l00nix/rpi-cm4-LiM-board/README.md

This repository builds the GitHub pages site: [https://lim.loonix.ca](https://lim.loonix.ca)
