l00nix/rpi-cm4-LiM-board/pages/LiM_Cluster_CB.md

---
title: LiM Cluster Carrier Board
layout: page
carousels:
  - images: 
    - image: /images/LiM_CM4_Cluster_CB/LiM_CM4_Cluster_CB5.png
    - image: /images/LiM_CM4_Cluster_CB/LiM_CM4_Cluster_CB1.jpg
    - image: /images/LiM_CM4_Cluster_CB/LiM_CM4_Cluster_CB2.jpg
    - image: /images/LiM_CM4_Cluster_CB/LiM_CM4_Cluster_CB3.jpg
    - image: /images/LiM_CM4_Cluster_CB/LiM_CM4_Cluster_CB4.jpg
    - image: /images/LiM_CM4_Cluster_CB/LiM_CM4_Cluster_CB6.jpg
---

# RPi CM4 - LiM Cluster Carrier Board

The third version of the minimalistic LiM Raspberry Pi (RPi) Compute Module 4 (CM4) Carrier Board series.  The Less-is-More (LiM) Cluster Board is a minimalistic Power over Ethernet (PoE) carrier board for the Raspberry Pi (RPi) Compute Module 4 (CM4). On a small footprint it features the following:

* RPi Pi Compute Module 4 (CM4) support (both versions with and w/o eMMC - Lite version)
* PoE Gigabit RJ45 port (GbE)
* USB-C (USB 2.0) for CM4 module flashing (power + data)
* toggle switch for boot/flash mode
* microSD card slot
* 2232 and 2241 M.2 M-key socket dedicated for NVMe PCIe SSD drives
* Fan Pins
* SDA, SDC, YCC, GND pins for OLED Displays

{% include carousel.html height="75" unit="%" duration="7" number="1" %}
_**Various LiM CM4 Cluster Carrier Board models**_

See also on [hackaday.io](https://hackaday.io/project/185519-lim-rpi-cm4-cluster-board){:target="_blank"}
