l00nix/rpi-cm4-LiM-board/pages/LiM+_Board.md

---
title: LiM+ Carrier Board
layout: page
---

# RPi CM4 - LiM+ Carrier Board

The second version of the minimalistic LiM Raspberry Pi (RPi) Compute Module 4 (CM4) Carrier Board. Less-is-More (LiM) refers to the minimalistic design in its [original version](../pages/LiM_Board.html) only providing 5V power via USB-C power connector and two status (power/activity) LEDs. The LiM+ Carrier Board is the 'larger' (not by size but by functionality) sibling to the LiM Board by adding flashing capability of the Compute Module 4. Flashing can be done similarly to the [flashing process](https://www.raspberrypi.org/documentation/hardware/computemodule/cm-emmc-flashing.md){:target="_blank"} with the [CM4 IO board](https://www.raspberrypi.org/products/compute-module-4-io-board/){:target="_blank"}. 

This board is also meant for CM4 boards with onboard storage and wifi as this carrier board provides no other functionalty other than power, status LEDs and above mentioned flashing capability.

It took about two months from idea to the prototype. The PCB design files are can be found [here](https://github.com/l00nix/rpi-cm4-LiM-board/tree/main/hardware/rpi-cm4-LiM%2B-board){:target="_blank"}. 

Here are some pictures and 3D renders of the LiM Carrier Board:

LiM+ Carrier Board - top view             |  LiM+ Carrier Board - bottom view
:-------------------------:|:-------------------------:
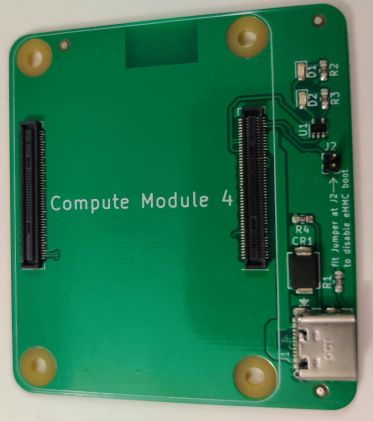
[picture p1: images/LiM+_top.jpg]
LiM+ Carrier Board Top View
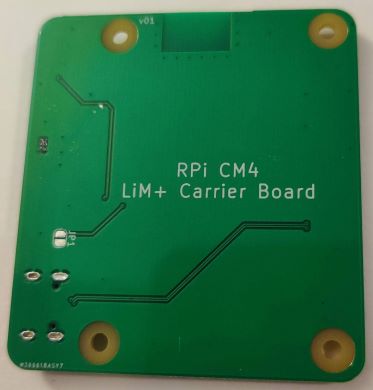
[picture p2: images/LiM+_bottom.jpg]
LiM+ Carrier Board Bottom View
  |  

LiM+ Carrier Board - with CM4             | 
:-------------------------:|:-------------------------:
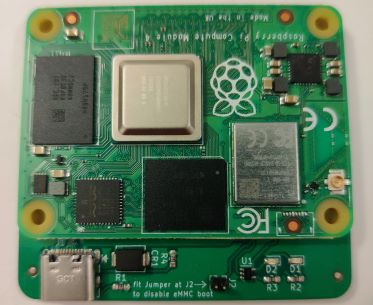
[picture p3: images/LiM+_with_CM4.jpg]
LiM+ Carrier Board with CM4 Module
  |

LiM+ Carrier Board 3D Render - top view             |  LiM+ Carrier Board 3D Render - bottom view
:-------------------------:|:-------------------------:
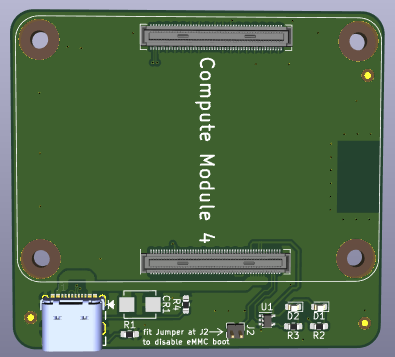
[picture p4: images/rpi-cm4-LiM+-board-3Dtop.PNG]
Rendered RPi CM4 LiM+ Carrier Board PCB Top
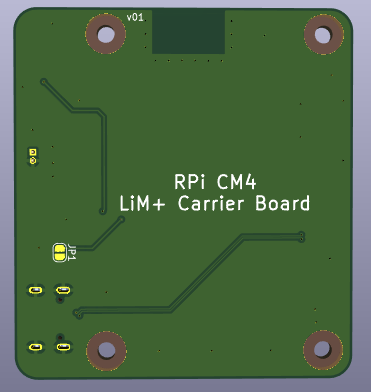
[picture p5: images/rpi-cm4-LiM+-board-3Dbottom.PNG]
Rendered RPi CM4 LiM+ Carrier Board PCB Bottom
  |  

LiM+ Carrier Board - 3D top view             |  LiM+ Carrier Board - 3D side view
:-------------------------:|:-------------------------:
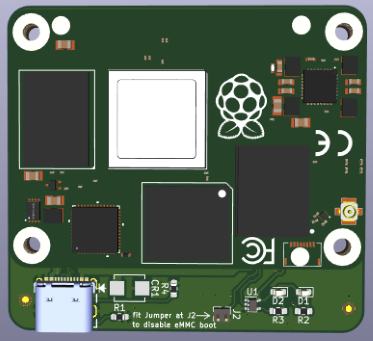
[picture p6: images/rpi-cm4-LiM+-board-3DtopwithCM4.PNG]
3D RPi CM4 LiM+ Carrier Board PCB Top
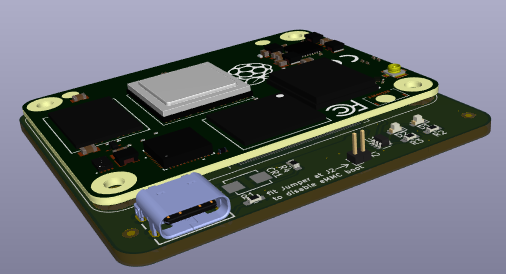
[picture p7: images/rpi-cm4-LiM+-board-3DsidewithCM4.PNG]
3D RPi CM4 LiM Carrier Board PCB Side
  |  

LiM+ Carrier Board - 3D breakout with heatsink             |  LiM+ Carrier Board - 3D with heatsink
:-------------------------:|:-------------------------:
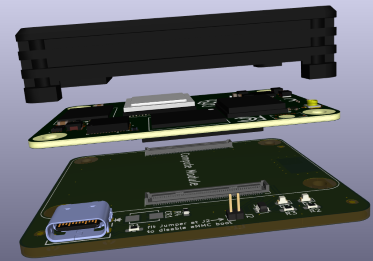
[picture p8: images/rpi-cm4-LiM+-board-3d-heatsink.PNG]
3D RPi CM4 LiM+ Carrier Board PCB breakout with heatsink
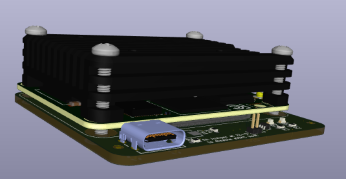
[picture p9: images/rpi-cm4-LiM+-board-3Dwithscrews.PNG]
3D RPi CM4 LiM Carrier Board PCB with heatsink
  |  

You can read more about my RPi musings and projects on my [l00nix's RPi Musings Blog](https://rpi.loonix.ca/){:target="_blank"}.

## About

[//]: # "GitHub Stats (https://github.com/l00nix/rpi-cm4-LiM-board){:target="_blank"}"
GitHub Stats (https://github.com/l00nix/rpi-cm4-LiM-board){:target="_blank"}

This project is maintained by [Alexander Rau](https://rpi.loonix.ca){:target="_blank"}. The Raspberry Pi Compute Module 4 is a product of [Raspberry Pi (Trading) Limited](https://www.raspberrypi.org/about/){:target="_blank"}.
