l00nix/rpi-cm4-LiM-board/pages/LiM_Board.md

---
layout: page
title: LiM Carrier Board
---

# RPi CM4 - LiM Carrier Board

The first version of the minimalistic Raspberry Pi (RPi) Compute Module 4 (CM4) Carrier Board. Less-is-More (LiM) refers to the minimalistic design only providing 5V power via USB-C power connector and two status (power/activity) LEDs.

This is meant for CM4 boards with onboard storage and wifi as this carrier board provides no other functionalty other than power and status LEDs.

It took about two months from idea to the prototype. The PCB design files are can be found [here](https://github.com/l00nix/rpi-cm4-LiM-board/tree/main/hardware/rpi-cm4-LiM-board). 

Here are some pictures and 3D renders of the LiM Carrier Board:

LiM Carrier Board - top view             |  LiM Carrier Board - bottom view
:-------------------------:|:-------------------------:
LiM Carrier Board Top View  |  Rendered RPi CM4 LiM Carrier Board PCB Bottom

LiM Carrier Board - with CM4             |  LiM Carrier Board - running
:-------------------------:|:-------------------------:
LiM Carrier Board Top View  |  Rendered RPi CM4 LiM Carrier Board PCB Bottom

<iframe width="560" height="315" src="https://www.youtube.com/embed/IoSWfgwpsAo" title="YouTube video player" frameborder="0" allow="accelerometer; autoplay; clipboard-write; encrypted-media; gyroscope; picture-in-picture" allowfullscreen></iframe>
_**VID1 - LiM Carrier Board booting up**_

LiM Carrier Board 2D Render - top view             |  LiM Carrier Board 2D Render - bottom view
:-------------------------:|:-------------------------:
Rendered RPi CM4 LiM Carrier Board PCB Top  |  Rendered RPi CM4 LiM Carrier Board PCB Bottom

LiM Carrier Board - 3D top view             |  LiM Carrier Board - 3D side view
:-------------------------:|:-------------------------:
3D RPi CM4 LiM Carrier Board PCB Top  |  3D RPi CM4 LiM Carrier Board PCB Side

You can read more about my RPi musings and projects on my [l00nix's RPi Musings Blog](https://rpi.loonix.ca/).

## About

[//]: # "GitHub Stats (https://github.com/l00nix/rpi-cm4-LiM-board)"
GitHub Stats (https://github.com/l00nix/rpi-cm4-LiM-board)

This project is maintained by [Alexander Rau](https://rpi.loonix.ca). The Raspberry Pi Compute Module 4 is a product of [Raspberry Pi (Trading) Limited](https://www.raspberrypi.org/about/).
