l00nix/rpi-cm4-LiM-board/images/IMG_20211019_1241092.jpg

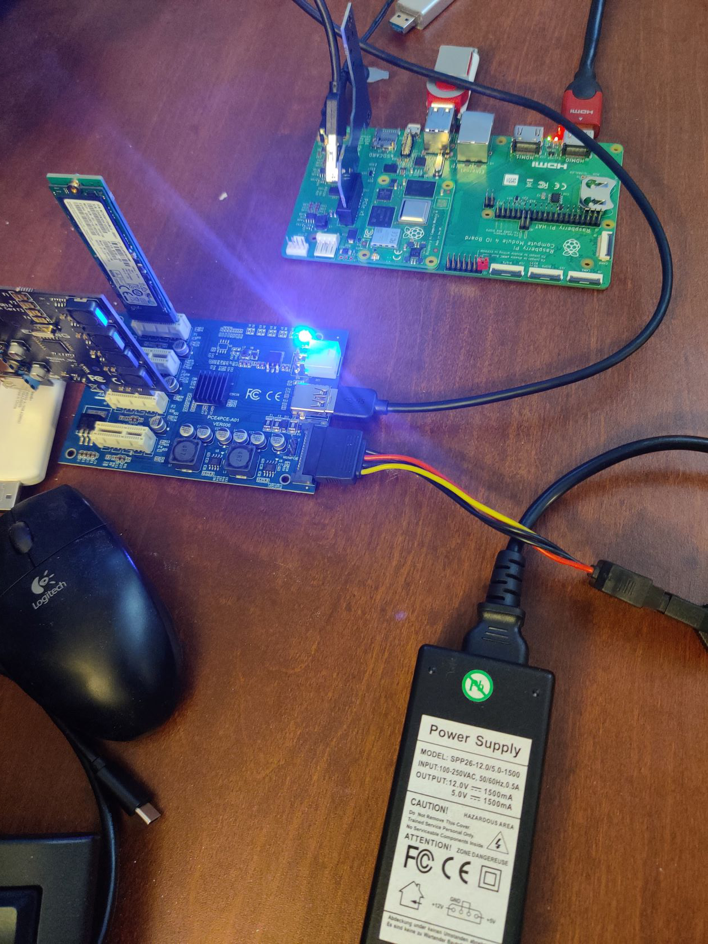
images/IMG_20211019_1241092.jpg
