l00nix/rpi-cm4-LiM-board/images/LiM_CM4_Cluster_CB/LiM_CM4_Cluster_CB2.jpg

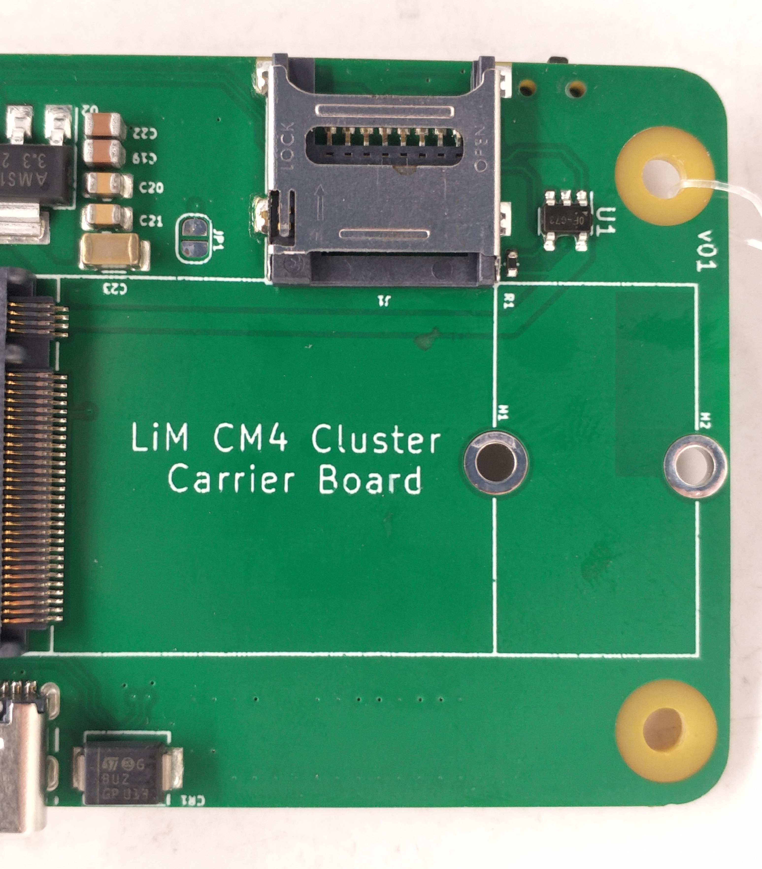
images/LiM_CM4_Cluster_CB/LiM_CM4_Cluster_CB2.jpg
