l00nix/rpi-cm4-LiM-board/hardware/rpi-cm4-LiM+-board/KiCad Files/USB4105-GF-A/USB4105-GF-A--3DModel-STEP-56544.STEP

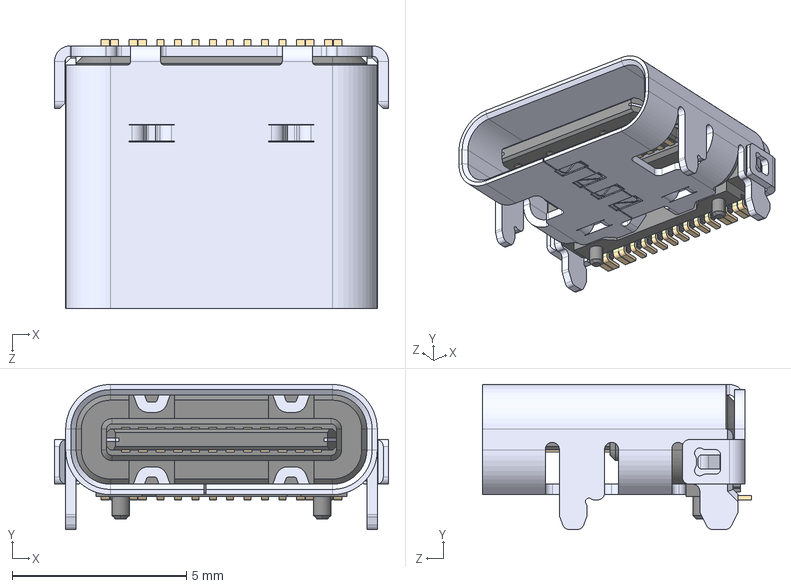
[picture p17: CAD file, 2021-07-24]
hardware/rpi-cm4-LiM+-board/KiCad Files/USB4105-GF-A/USB4105-GF-A--3DModel-STEP-56544.STEP
9.58 x 4.16 x 7.71 mm
