l00nix/rpi-cm4-LiM-board/hardware/rpi-cm4-LiM+-board/KiCad Files/Screw/95836A283_BLACK-OXIDE 18-8 STAINLESS STEEL PAN HEAD PHILLIPS SCREWS.STEP

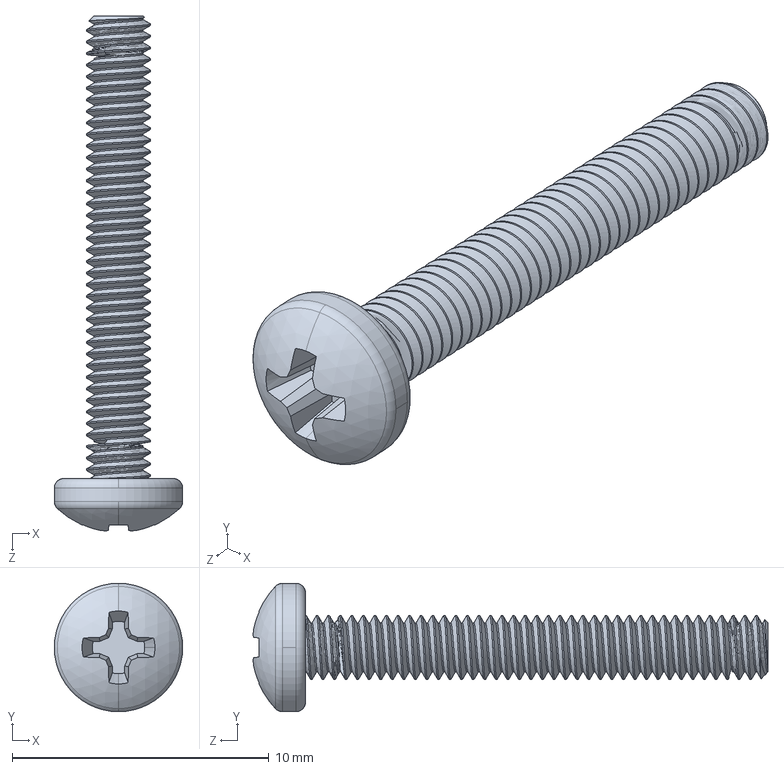
[picture p18: CAD file, 2021-08-02]
hardware/rpi-cm4-LiM+-board/KiCad Files/Screw/95836A283_BLACK-OXIDE 18-8 STAINLESS STEEL PAN HEAD PHILLIPS SCREWS.STEP
5.00 x 5.00 x 20.0 mm
