l00nix/rpi-cm4-LiM-board/hardware/rpi-cm4-LiM+-board/KiCad Files/Screw/96315A112_METRIC 18-8 STAINLESS STEEL THIN HEX NUTS.STEP

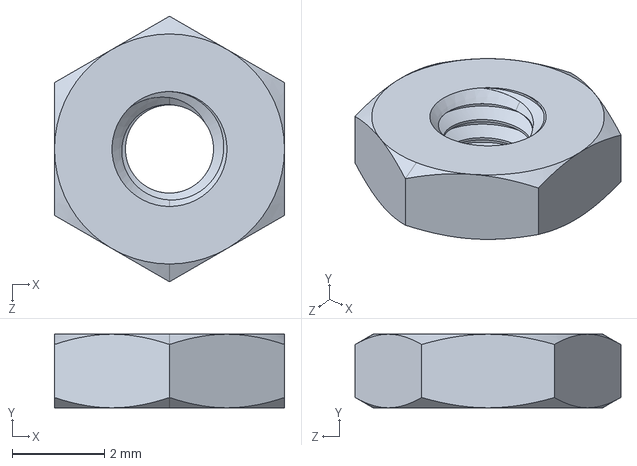
[picture p19: CAD file, 2021-08-02]
hardware/rpi-cm4-LiM+-board/KiCad Files/Screw/96315A112_METRIC 18-8 STAINLESS STEEL THIN HEX NUTS.STEP
5.00 x 1.60 x 5.77 mm
