l00nix/rpi-cm4-LiM-board/hardware/rpi-cm4-LiM-board/KiCad Files/rpi-cm4-LiM-board.pdf

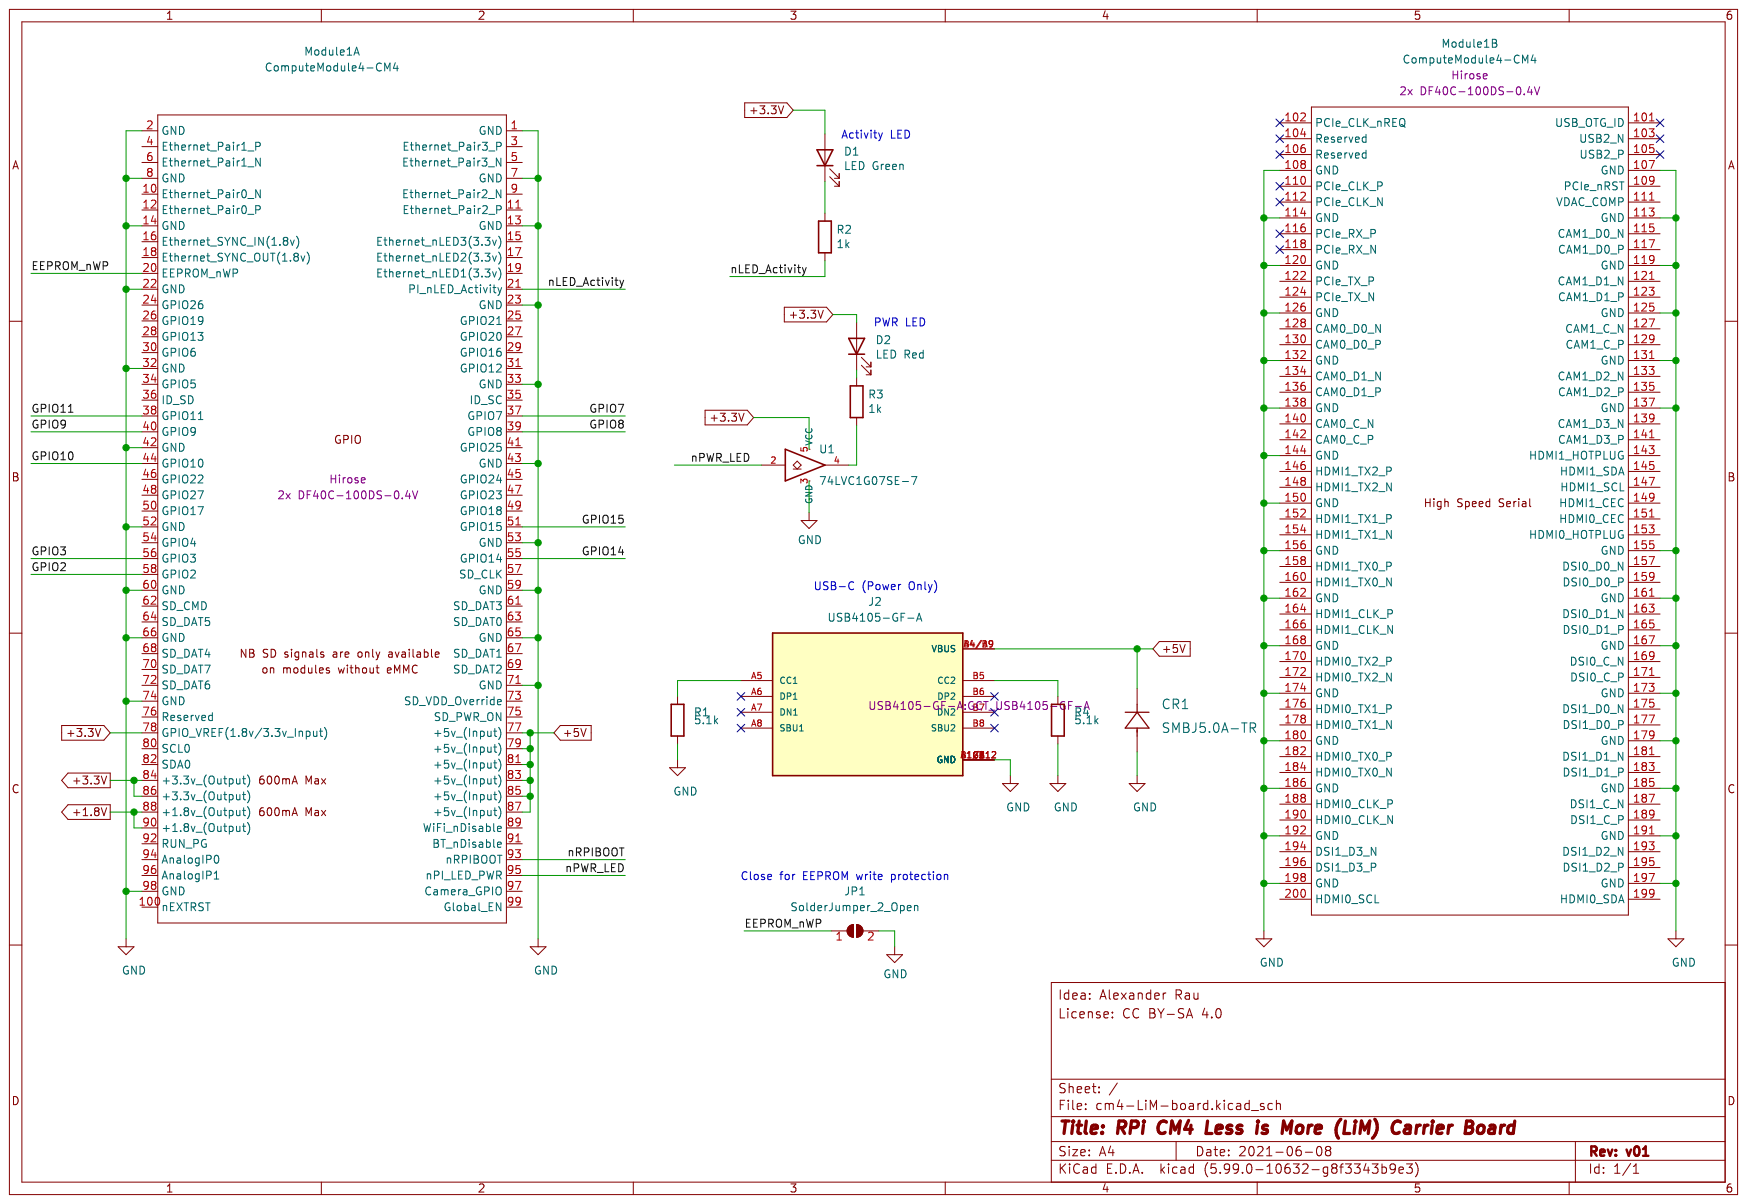
[picture p20: page 1]
