l00nix/rpi-cm4-LiM-board/hardware/rpi-cm4-LiM+-board/KiCad Files/rpi-cm4-LiM+-board.kicad_sch

## KiCad design hardware/rpi-cm4-LiM+-board/KiCad Files/rpi-cm4-LiM+-board.kicad_sch (2021-07-24)

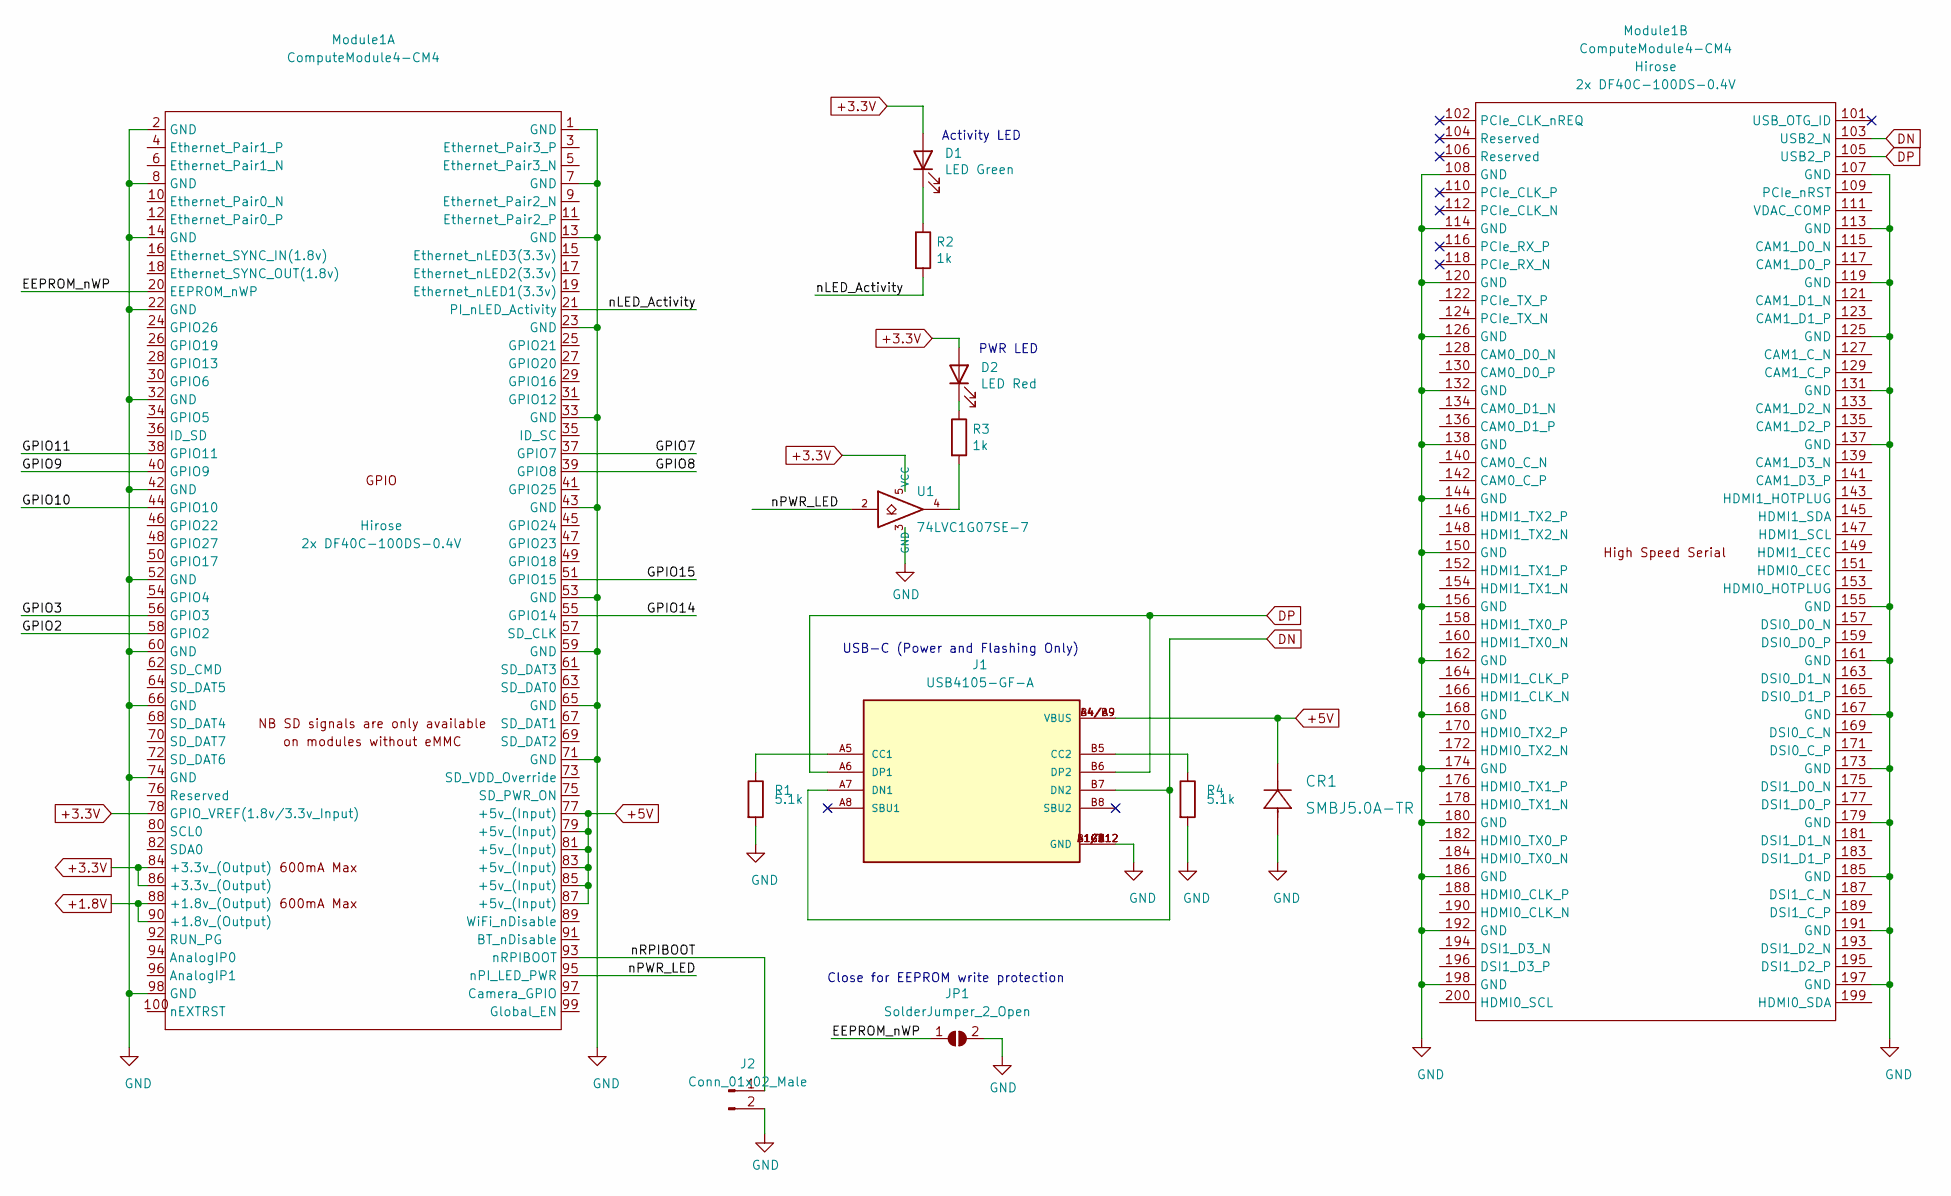
[picture p23: schematic rpi-cm4-LiM+-board.kicad_sch]

Parts:
CR1: SMBJ5.0A-TR; MPN SMBJ5.0A-TR; Digi-Key_PN 497-3144-1-ND
D1: LED Green; LED_0603_1608Metric; Part Description Green 572nm LED Indication - Discrete 2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; Digi-Key_PN 160-1478-1-ND
D2: LED Red; LED_0603_1608Metric; Part Description Red 620nm LED Indication - Discrete 2.2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; Digi-Key_PN 160-1479-1-ND
J1: USB4105-GF-A; GCT_USB4105-GF-A; MPN USB4105-GF-A; Digi-Key_PN 2073-USB4105-GF-ACT-ND
J2: Conn_01x02_Male; PinHeader_1x02_P1.27mm_Vertical
JP1: SolderJumper_2_Open; SolderJumper-2_P1.3mm_Open_RoundedPad1.0x1.5mm
Module1: ComputeModule4-CM4; Raspberry-Pi-4-Compute-Module; MPN 2x DF40C-100DS-0.4V; Digi-Key_PN 2x H11615CT-ND
R1, R4: 5.1k; R_0603_1608Metric_Pad0.98x0.95mm_HandSolder; MPN RC0603FR-075K1L; Digi-Key_PN 311-5.10KHRCT-ND
R2, R3: 1k; R_0603_1608Metric_Pad0.98x0.95mm_HandSolder; MPN RC0603FR-071KL; Digi-Key_PN 311-1.00KHRCT-ND
U1: 74LVC1G07SE-7; SOT-353_SC-70-5; Part Description Buffer, Non-Inverting 1 Element 1 Bit p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; Digi-Key_PN 74LVC1G07SE-7DICT-ND

Connections:
+1.8V: Module1.88 (+1.8v_(Output)), Module1.90 (+1.8v_(Output))
+3.3V: D1.2 (A), D2.2 (A), Module1.78 (GPIO_VREF(1.8v/3.3v_Input)), Module1.84 (+3.3v_(Output)), Module1.86 (+3.3v_(Output)), U1.5 (VCC)
+5V: CR1.1, J1.A4/B9 (VBUS), J1.B4/A9 (VBUS), Module1.77 (+5v_(Input)), Module1.79 (+5v_(Input)), Module1.81 (+5v_(Input)), Module1.83 (+5v_(Input)), Module1.85 (+5v_(Input)), Module1.87 (+5v_(Input))
DN: J1.A7 (DN1), J1.B7 (DN2), Module1.103 (USB2_N)
DP: J1.A6 (DP1), J1.B6 (DP2), Module1.105 (USB2_P)
EEPROM_nWP: JP1.1 (A), Module1.20 (EEPROM_nWP)
GND: CR1.2, J1.A1/B12 (GND), J1.B1/A12 (GND), J1.G1 (GND), J1.G2 (GND), J1.G3 (GND), J1.G4 (GND), J2.2, JP1.2 (B), Module1.1 (GND), Module1.2 (GND), Module1.7 (GND), Module1.8 (GND), Module1.13 (GND), Module1.14 (GND), Module1.22 (GND), Module1.23 (GND), Module1.32 (GND), Module1.33 (GND), Module1.42 (GND), Module1.43 (GND), Module1.52 (GND), Module1.53 (GND), Module1.59 (GND), Module1.60 (GND), Module1.65 (GND), Module1.66 (GND), Module1.71 (GND), Module1.74 (GND), Module1.98 (GND), Module1.107 (GND), Module1.108 (GND), Module1.113 (GND), Module1.114 (GND), Module1.119 (GND), Module1.120 (GND), Module1.125 (GND), Module1.126 (GND), Module1.131 (GND), Module1.132 (GND), Module1.137 (GND), Module1.138 (GND), Module1.144 (GND), Module1.150 (GND), Module1.155 (GND), Module1.156 (GND), Module1.161 (GND), Module1.162 (GND), Module1.167 (GND), Module1.168 (GND), Module1.173 (GND), Module1.174 (GND), Module1.179 (GND), Module1.180 (GND), Module1.185 (GND), Module1.186 (GND), Module1.191 (GND), Module1.192 (GND), Module1.197 (GND), Module1.198 (GND), R1.2, R4.2, U1.3 (GND)
GPIO2: Module1.58 (GPIO2)
GPIO3: Module1.56 (GPIO3)
GPIO7: Module1.37 (GPIO7)
GPIO8: Module1.39 (GPIO8)
GPIO9: Module1.40 (GPIO9)
GPIO10: Module1.44 (GPIO10)
GPIO11: Module1.38 (GPIO11)
GPIO14: Module1.55 (GPIO14)
GPIO15: Module1.51 (GPIO15)
unnamed: D1.1 (K), R2.1
unnamed: D2.1 (K), R3.1
unnamed: J1.A5 (CC1), R1.1
unnamed: J1.B5 (CC2), R4.1
unnamed: R3.2, U1.4
nLED_Activity: Module1.21 (PI_nLED_Activity), R2.2
nPWR_LED: Module1.95 (nPI_LED_PWR), U1.2
nRPIBOOT: J2.1, Module1.93 (nRPIBOOT)

Notes on the sheet:
Activity LED
PWR LED
Close for EEPROM write protection
USB-C (Power and Flashing Only)
