l00nix/rpi-cm4-LiM-board/(commit log)

2021-07-24 added LiM+ board pages and other updates to KiCad files and renderings
    [USB4105-GF-A--3DModel-STEP-56544.STEP, cm4-gpio.kicad_sch, cm4-high-speed.kicad_sch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]
2021-07-26 LiM Carrier Board series website - second release
2021-08-02 updated LiM board with heatsink screws and added pictures
    [95836A283_BLACK-OXIDE 18-8 STAINLESS STEEL PAN HEAD PHILLIPS SCREWS.STEP, 96315A112_METRIC 18-8 STAINLESS STEEL THIN HEX NUTS.STEP, rpi-cm4-LiM+-board.kicad_pcb]
2021-08-05 KiCad updates 3D iamges
2022-05-28 added back to top button and prepped cluster board page
2023-01-02 Updates for LiM CM4 Cluster Board
