l00nix/rpi-cm4-LiM-board/(notices)

Notices in the files:
hardware/rpi-cm4-LiM+-board/KiCad Files/rpi-cm4-LiM+-board.kicad_sch:
License: CC BY-SA 4.0
hardware/rpi-cm4-LiM-board/KiCad Files/rpi-cm4-LiM-board.kicad_pcb:
creativecommons.org/licenses/by/4.0
parts and their libraries:
Copyright 2016 Accelerated Designs. All rights reserved.
